RoastedSalsa/Mini-3-DoF-BLDC-Robot-Arm/(list of files, cad)

Other CAD files:
Mark1/analysis/simulink/basic_ik/Base.step
Mark1/analysis/simulink/gravity/Part 2.step
Mark1/analysis/simulink/gravity2/Part 2.step
Mark1/ros2/src/full_assembly/meshes/GT2_20T.stl
Mark1/analysis/simulink/basic_ik/Part 12.step
Mark1/analysis/simulink/gravity/Base1.step
Mark1/analysis/simulink/gravity2/Part 21.step
Mark1/ros2/src/full_assembly/meshes/Link1_Attachment.stl
Mark1/analysis/simulink/basic_ik/Part 14.step
Mark1/analysis/simulink/gravity/Part 21.step
Mark1/analysis/simulink/gravity2/Part 14.step
Mark1/ros2/src/full_assembly/meshes/GM3506_Stator.stl
Mark1/analysis/simulink/basic_ik/Part 21.step
Mark1/analysis/simulink/gravity/Part 12.step
Mark1/analysis/simulink/gravity2/Part 13.step
Mark1/ros2/src/full_assembly/meshes/Link3.stl
Mark1/analysis/simulink/basic_ik/Part 2.step
Mark1/analysis/simulink/gravity/Part 11.step
Mark1/analysis/simulink/gravity2/Part 12.step
Mark1/ros2/src/full_assembly/meshes/Bearring.stl
Mark1/analysis/simulink/basic_ik/Part 13.step
Mark1/analysis/simulink/gravity/Part 1.step
Mark1/analysis/simulink/gravity2/Base.step
Mark1/ros2/src/full_assembly/meshes/GM3506_Rotor.stl
Mark1/analysis/simulink/basic_ik/Part 11.step
Mark1/analysis/simulink/gravity/Part 13.step
Mark1/analysis/simulink/gravity2/Part 11.step
Mark1/ros2/src/full_assembly/meshes/Link2.stl
Mark1/analysis/simulink/basic_ik/Part 1.step
Mark1/analysis/simulink/gravity/Part 14.step
Mark1/analysis/simulink/gravity2/Part 1.step
Mark1/ros2/src/full_assembly/meshes/Base.stl
Mark1/ros2/src/full_assembly/meshes/GBM2804_Rotor.stl
Mark1/ros2/src/full_assembly/meshes/Link1_Body.stl
Mark1/ros2/src/full_assembly/meshes/GBM2804_Stator.stl
