RoastedSalsa/Mini-3-DoF-BLDC-Robot-Arm/Mark1/ros2/src/full_assembly/urdf/full_assembly.urdf

<!--URDF generated by ONSHAPE BY PTC INC, 1.218-->
<robot name="full_assembly">
    <link name="base">
        <inertial>
            <mass value="0.176007" />
            <origin xyz="6.77725e-18 0.000809394 0.0197186" rpy="0 -0 0" />
            <inertia ixx="0.000202067" ixy="0" ixz="0" iyy="0.000207068" iyz="-6.31167e-07" izz="0.000384759" />
        </inertial>
        <visual>
            <origin xyz="1.03684e-19 -2.1684e-18 0.02" rpy="0 -0 0" />
            <geometry>
                <mesh filename="package://full_assembly/meshes/Base.stl" scale="1 1 1" />
            </geometry>
            <material name="0.615686_0.811765_0.929412_0.000000_0.000000">
                <color rgba="0.615686 0.811765 0.929412 1" />
            </material>
        </visual>
    </link>
    <link name="bearring">
        <inertial>
            <mass value="3.43062e-06" />
            <origin xyz="-4.27555e-18 -5.77779e-34 0.0035" rpy="0 -0 0" />
            <inertia ixx="3.19333e-10" ixy="0" ixz="0" iyy="3.19333e-10" iyz="0" izz="6.1065e-10" />
        </inertial>
        <visual>
            <origin xyz="-5.18498e-18 -1.21523e-18 0.0025" rpy="0 -0 0" />
            <geometry>
                <mesh filename="package://full_assembly/meshes/Bearring.stl" scale="1 1 1" />
            </geometry>
            <material name="0.917647_0.917647_0.917647_0.000000_0.000000">
                <color rgba="0.917647 0.917647 0.917647 1" />
            </material>
        </visual>
    </link>
    <link name="earth_mate">
        <inertial>
            <mass value="1e-09" />
            <origin xyz="0 0 0" rpy="0 -0 0" />
            <inertia ixx="4e-14" ixy="0" ixz="0" iyy="4e-14" iyz="0" izz="4e-14" />
        </inertial>
    </link>
    <link name="ee_mate">
        <inertial>
            <mass value="1e-09" />
            <origin xyz="0 0 0" rpy="0 -0 0" />
            <inertia ixx="4e-14" ixy="0" ixz="0" iyy="4e-14" iyz="0" izz="4e-14" />
        </inertial>
    </link>
    <link name="gbm2804_rotor">
        <inertial>
            <mass value="0.0216029" />
            <origin xyz="-9.60258e-20 1.20158e-20 -0.00546488" rpy="0 -0 0" />
            <inertia ixx="1.89079e-06" ixy="0" ixz="0" iyy="1.89079e-06" iyz="0" izz="3.3475e-06" />
        </inertial>
        <visual>
            <origin xyz="2.3486e-19 -1.10246e-18 -0.011" rpy="0 -0 0" />
            <geometry>
                <mesh filename="package://full_assembly/meshes/GBM2804_Rotor.stl" scale="1 1 1" />
            </geometry>
            <material name="0.615686_0.811765_0.929412_0.000000_0.000000">
                <color rgba="0.615686 0.811765 0.929412 1" />
            </material>
        </visual>
    </link>
    <link name="gbm2804_stator">
        <inertial>
            <mass value="0.00883949" />
            <origin xyz="-2.17814e-18 8.26292e-19 -0.00149587" rpy="0 -0 0" />
            <inertia ixx="6.47839e-07" ixy="0" ixz="0" iyy="6.47839e-07" iyz="0" izz="1.23717e-06" />
        </inertial>
        <visual>
            <origin xyz="-2.16634e-18 -1.98046e-19 -0.015" rpy="0 -0 0" />
            <geometry>
                <mesh filename="package://full_assembly/meshes/GBM2804_Stator.stl" scale="1 1 1" />
            </geometry>
            <material name="0.647059_0.647059_0.647059_0.000000_0.000000">
                <color rgba="0.647059 0.647059 0.647059 1" />
            </material>
        </visual>
    </link>
    <link name="gm3506_rotor">
        <inertial>
            <mass value="0.0383311" />
            <origin xyz="-6.99227e-19 -1.14387e-18 -0.00661149" rpy="0 -0 1.5708" />
            <inertia ixx="4.6146e-06" ixy="0" ixz="0" iyy="4.6146e-06" iyz="0" izz="7.78531e-06" />
        </inertial>
        <visual>
            <origin xyz="5.51091e-19 6.11834e-34 -0.014" rpy="0 -0 1.5708" />
            <geometry>
                <mesh filename="package://full_assembly/meshes/GM3506_Rotor.stl" scale="1 1 1" />
            </geometry>
            <material name="0.615686_0.811765_0.929412_0.000000_0.000000">
                <color rgba="0.615686 0.811765 0.929412 1" />
            </material>
        </visual>
    </link>
    <link name="gm3506_rotor_1">
        <inertial>
            <mass value="0.0383311" />
            <origin xyz="-6.99227e-19 -1.14387e-18 -0.00661149" rpy="0 -0 1.5708" />
            <inertia ixx="4.6146e-06" ixy="0" ixz="0" iyy="4.6146e-06" iyz="0" izz="7.78531e-06" />
        </inertial>
        <visual>
            <origin xyz="5.51091e-19 6.11834e-34 -0.014" rpy="0 -0 1.5708" />
            <geometry>
                <mesh filename="package://full_assembly/meshes/GM3506_Rotor.stl" scale="1 1 1" />
            </geometry>
            <material name="0.615686_0.811765_0.929412_0.000000_0.000000">
                <color rgba="0.615686 0.811765 0.929412 1" />
            </material>
        </visual>
    </link>
    <link name="gm3506_stator">
        <inertial>
            <mass value="0.00806633" />
            <origin xyz="-1.52459e-18 -0.000466632 -0.00190339" rpy="0 -0 0" />
            <inertia ixx="9.36986e-07" ixy="0" ixz="0" iyy="1.00259e-06" iyz="1.27752e-11" izz="1.92012e-06" />
        </inertial>
        <visual>
            <origin xyz="0 -1.22465e-18 -0.0178" rpy="0 -0 0" />
            <geometry>
                <mesh filename="package://full_assembly/meshes/GM3506_Stator.stl" scale="1 1 1" />
            </geometry>
            <material name="0.647059_0.647059_0.647059_0.000000_0.000000">
                <color rgba="0.647059 0.647059 0.647059 1" />
            </material>
        </visual>
    </link>
    <link name="gm3506_stator_1">
        <inertial>
            <mass value="0.00806633" />
            <origin xyz="-1.52459e-18 -0.000466632 -0.00190339" rpy="0 -0 0" />
            <inertia ixx="9.36986e-07" ixy="0" ixz="0" iyy="1.00259e-06" iyz="1.27752e-11" izz="1.92012e-06" />
        </inertial>
        <visual>
            <origin xyz="0 -1.22465e-18 -0.0178" rpy="0 -0 0" />
            <geometry>
                <mesh filename="package://full_assembly/meshes/GM3506_Stator.stl" scale="1 1 1" />
            </geometry>
            <material name="0.647059_0.647059_0.647059_0.000000_0.000000">
                <color rgba="0.647059 0.647059 0.647059 1" />
            </material>
        </visual>
    </link>
    <link name="gt2_20t">
        <inertial>
            <mass value="1.18228e-05" />
            <origin xyz="0.00345942 1.29148e-18 -1.92249e-06" rpy="0 -0 0" />
            <inertia ixx="2.02107e-09" ixy="0" ixz="-4.99121e-13" iyy="1.36706e-09" iyz="0" izz="1.36714e-09" />
        </inertial>
        <visual>
            <origin xyz="0.001 0 -2.60237e-19" rpy="0 -0 0" />
            <geometry>
                <mesh filename="package://full_assembly/meshes/GT2_20T.stl" scale="1 1 1" />
            </geometry>
            <material name="0.972549_0.529412_0.003922_0.000000_0.000000">
                <color rgba="0.972549 0.529412 0.00392157 1" />
            </material>
        </visual>
    </link>
    <link name="link1_attachment">
        <inertial>
            <mass value="0.0283697" />
            <origin xyz="-0.0453376 -0.00351665 0.0246244" rpy="0 -0 0" />
            <inertia ixx="5.01432e-06" ixy="-1.53773e-08" ixz="1.92295e-06" iyy="2.25478e-05" iyz="1.64174e-09" izz="1.77649e-05" />
        </inertial>
        <visual>
            <origin xyz="-0.02 0.0245 0" rpy="0 -0 0" />
            <geometry>
                <mesh filename="package://full_assembly/meshes/Link1_Attachment.stl" scale="1 1 1" />
            </geometry>
            <material name="0.615686_0.811765_0.929412_0.000000_0.000000">
                <color rgba="0.615686 0.811765 0.929412 1" />
            </material>
        </visual>
    </link>
    <link name="link1_body">
        <inertial>
            <mass value="0.0510964" />
            <origin xyz="-0.00434002 -0.0111291 0.0209622" rpy="0 -0 0" />
            <inertia ixx="1.80075e-05" ixy="-1.87854e-06" ixz="1.36583e-06" iyy="1.95321e-05" iyz="1.40635e-06" izz="1.31797e-05" />
        </inertial>
        <visual>
            <origin xyz="0 2.60237e-19 0" rpy="0 -0 0" />
            <geometry>
                <mesh filename="package://full_assembly/meshes/Link1_Body.stl" scale="1 1 1" />
            </geometry>
            <material name="0.615686_0.811765_0.929412_0.000000_0.000000">
                <color rgba="0.615686 0.811765 0.929412 1" />
            </material>
        </visual>
    </link>
    <link name="link2">
        <inertial>
            <mass value="0.0906071" />
            <origin xyz="-2.11926e-16 -0.0930749 -0.00660831" rpy="0 -0 0" />
            <inertia ixx="0.000377155" ixy="0" ixz="0" iyy="1.34721e-05" iyz="-3.30071e-06" izz="0.000388504" />
        </inertial>
        <visual>
            <origin xyz="0 8.57253e-19 0.0025" rpy="0 -0 0" />
            <geometry>
                <mesh filename="package://full_assembly/meshes/Link2.stl" scale="1 1 1" />
            </geometry>
            <material name="0.792157_0.819608_0.933333_0.000000_0.000000">
                <color rgba="0.792157 0.819608 0.933333 1" />
            </material>
        </visual>
    </link>
    <link name="link3">
        <inertial>
            <mass value="0.0593435" />
            <origin xyz="-7.74892e-07 0.00676054 0.0719665" rpy="0 -0 0" />
            <inertia ixx="0.00019525" ixy="4.15678e-10" ixz="5.57351e-09" iyy="0.00019374" iyz="-2.66666e-05" izz="8.18807e-06" />
        </inertial>
        <visual>
            <origin xyz="-3.25001e-19 0 -4.33681e-19" rpy="0 -0 0" />
            <geometry>
                <mesh filename="package://full_assembly/meshes/Link3.stl" scale="1 1 1" />
            </geometry>
            <material name="0.615686_0.811765_0.929412_0.000000_0.000000">
                <color rgba="0.615686 0.811765 0.929412 1" />
            </material>
        </visual>
    </link>
    <link name="root" />
    <joint name="bearing_revolute" type="continuous">
        <origin xyz="-5.18498e-18 1.38778e-17 4.33681e-19" rpy="1.01109e-14 7.90371e-15 -1.5708" />
        <axis xyz="-0 -0 1" />
        <parent link="bearring" />
        <child link="link2" />
    </joint>
    <joint name="earth_mate" type="fixed">
        <origin xyz="0 0 -7.70372e-34" rpy="-3.30796e-61 1.97215e-31 -1.99229e-31" />
        <axis xyz="0 0 1" />
        <parent link="base" />
        <child link="earth_mate" />
    </joint>
    <joint name="ee_mate" type="fixed">
        <origin xyz="-2.77556e-17 0.0158 0.2" rpy="1.26218e-29 -1.57772e-30 2.46519e-32" />
        <axis xyz="0 0 1" />
        <parent link="link3" />
        <child link="ee_mate" />
    </joint>
    <joint name="fastened_1" type="fixed">
        <origin xyz="-6.15827e-18 -3.36576e-18 6.93889e-18" rpy="6.43662e-15 -6.43662e-15 -1.5708" />
        <axis xyz="-0 -0 -1" />
        <parent link="root" />
        <child link="base" />
    </joint>
    <joint name="fastened_2" type="fixed">
        <origin xyz="1.38778e-17 0 -0.011" rpy="1.5708 -5.54861e-16 -3.14159" />
        <axis xyz="0 1 0" />
        <parent link="gbm2804_rotor" />
        <child link="link3" />
    </joint>
    <joint name="fastened_3" type="fixed">
        <origin xyz="-3.36576e-18 6.07153e-19 0.03" rpy="-3.14159 1.24633e-15 -2.32179e-15" />
        <axis xyz="0 0 1" />
        <parent link="base" />
        <child link="gm3506_stator_1" />
    </joint>
    <joint name="fastened_4" type="fixed">
        <origin xyz="0.02 -0.0245 6.93889e-18" rpy="-1.43038e-16 5.92868e-16 1.69309e-15" />
        <axis xyz="1.73472e-16 1 -0" />
        <parent link="link1_body" />
        <child link="link1_attachment" />
    </joint>
    <joint name="fastened_5" type="fixed">
        <origin xyz="-0.0778938 1.38778e-17 0.0281002" rpy="1.5708 5.43881e-17 -1.09899e-16" />
        <axis xyz="0 0 1" />
        <parent link="link1_attachment" />
        <child link="gm3506_stator" />
    </joint>
    <joint name="fastened_6" type="fixed">
        <origin xyz="-1.38778e-17 -0.2 -0.002" rpy="-3.14159 -8.84709e-17 -2.77556e-16" />
        <axis xyz="0 0 1" />
        <parent link="link2" />
        <child link="gbm2804_stator" />
    </joint>
    <joint name="fastened_7" type="fixed">
        <origin xyz="-9.18861e-18 0.0028 0.0365" rpy="1.5708 1.1437e-14 3.14159" />
        <axis xyz="0 0 -1" />
        <parent link="link1_body" />
        <child link="bearring" />
    </joint>
    <joint name="fastened_8" type="fixed">
        <origin xyz="2.87792e-19 -8.01187e-32 -0.014" rpy="3.14159 -5.13683e-16 1.5708" />
        <axis xyz="0 0 -1" />
        <parent link="gm3506_rotor_1" />
        <child link="link1_body" />
    </joint>
    <joint name="fastened_9" type="fixed">
        <origin xyz="0 0 -0.014" rpy="0 1.5708 1.5708" />
        <axis xyz="-1 -0 -0" />
        <parent link="gm3506_rotor" />
        <child link="gt2_20t" />
    </joint>
    <joint name="gbm2804_revolute" type="continuous">
        <origin xyz="-1.38778e-17 2.77556e-17 -0.004" rpy="1.52766e-14 -1.39216e-15 2.07169e-15" />
        <axis xyz="-0 -0 1" />
        <parent link="gbm2804_stator" />
        <child link="gbm2804_rotor" />
    </joint>
    <joint name="gm3506_revolute" type="continuous">
        <origin xyz="4.92855e-18 5.38849e-17 -0.0038" rpy="7.06242e-16 -2.11404e-16 -1.19984e-13" />
        <axis xyz="0 0 1" />
        <parent link="gm3506_stator_1" />
        <child link="gm3506_rotor_1" />
    </joint>
    <joint name="gm3506_revolute_1" type="continuous">
        <origin xyz="-5.75928e-16 0 -0.0038" rpy="-3.72737e-16 -2.02003e-14 1.65079e-15" />
        <axis xyz="0 0 1" />
        <parent link="gm3506_stator" />
        <child link="gm3506_rotor" />
    </joint>
</robot>
