RoastedSalsa/Mini-3-DoF-BLDC-Robot-Arm/Mark1/firmware/src/diagnostics/position.cpp

#include "PinNames.h"
#include "variant_NUCLEO_G474RE.h"
#include <Arduino.h>
#include <Wire.h>
#include <SimpleFOC.h>
#include "config.h"

// === Motor selection — comment out to disable ===
#define ENABLE_MOTOR1
#define ENABLE_MOTOR2
#define ENABLE_MOTOR3

// === I2C buses ===
TwoWire myWire1(S1_SDA_PIN, S1_SCL_PIN);  // I2C1 HW — sensor 1 (SDA, SCL)
TwoWire myWire2(S2_SDA_PIN, S2_SCL_PIN);  // I2C3 HW — sensor 2 (SDA, SCL)
TwoWire myWire3(S3_SDA_PIN, S3_SCL_PIN);  // I2C4 HW — sensor 3 (SDA, SCL)

// === Sensors ===
MagneticSensorI2C sensor1 = MagneticSensorI2C(AS5600_I2C);
MagneticSensorI2C sensor2 = MagneticSensorI2C(AS5600_I2C);
MagneticSensorI2C sensor3 = MagneticSensorI2C(AS5600_I2C);

// === Motors ===
BLDCMotor motor1 = BLDCMotor(M1_POLE_PAIRS);
BLDCMotor motor2 = BLDCMotor(M2_POLE_PAIRS);
BLDCMotor motor3 = BLDCMotor(M3_POLE_PAIRS);

// === Drivers ===
BLDCDriver3PWM driver1 = BLDCDriver3PWM(M1_PH_A, M1_PH_B,  M1_PH_C, M1_EN);   // TIM1
BLDCDriver3PWM driver2 = BLDCDriver3PWM(M2_PH_A, M2_PH_B,  M2_PH_C, M2_EN);  // TIM2
BLDCDriver3PWM driver3 = BLDCDriver3PWM(M3_PH_A, M3_PH_B,  M3_PH_C, M3_EN);  // PA6=TIM3_CH1, PB5=TIM3_CH2, PB6=TIM4_CH1 (PB0 unusable: only TIM1_CH2N / TIM3_CH3-via-ALT, both fail in SimpleFOC)

// === Targets ===
float target1 = 4.0f, target2 = -1.0f, target3 = 3.5f;

Commander command = Commander(Serial);

// Print the calibration result for one motor after initFOC().
void reportMotor(const char* name, BLDCMotor& m) {
    Serial.print(name);
    Serial.print(" done  zero_electric_angle=");
    Serial.print(m.zero_electric_angle, 4);
    Serial.print("  dir=");
    Serial.println(m.sensor_direction == Direction::CW ? "CW"
                 : m.sensor_direction == Direction::CCW ? "CCW" : "UNKNOWN");
}

#ifdef ENABLE_MOTOR1
void onTarget1(char* cmd) { command.scalar(&target1, cmd); }
#endif
#ifdef ENABLE_MOTOR2
void onTarget2(char* cmd) { command.scalar(&target2, cmd); }
#endif
#ifdef ENABLE_MOTOR3
void onTarget3(char* cmd) { command.scalar(&target3, cmd); }
#endif

void setup() {
    Serial.begin(115200);
    while (!Serial && millis() < 2000);

    //SimpleFOCDebug::enable(&Serial);   // uncomment for full driver/sensor/FOC init diagnostics

#ifdef ENABLE_MOTOR1
    myWire1.begin();
    myWire1.setClock(I2C_CLOCK_HZ);
    sensor1.init(&myWire1);
    delay(50);

    driver1.voltage_power_supply = SUPPLY_VOLTAGE;
    driver1.init();

    motor1.linkSensor(&sensor1);
    motor1.linkDriver(&driver1);
    motor1.voltage_limit            = VOLTAGE_LIMIT;
    motor1.PID_velocity.P           = 0.3f;
    motor1.PID_velocity.I           = 0.1f;
    motor1.PID_velocity.output_ramp = 1000.0f;
    motor1.P_angle.P                = 10.0f;
    motor1.P_angle.I                = 1.0f;
    motor1.P_angle.D                = 0.05f;
    motor1.velocity_limit           = 100.0f;
    motor1.LPF_velocity.Tf          = 0.01f;
    motor1.zero_electric_angle      = 1.2732f;
    motor1.sensor_direction         = Direction::CW;
    motor1.init();
    motor1.initFOC();
    motor1.controller = MotionControlType::angle;
    reportMotor("M1", motor1);
    command.add('1', onTarget1, "target motor1");
#endif

#ifdef ENABLE_MOTOR2
    myWire2.begin();
    myWire2.setClock(I2C_CLOCK_HZ);
    sensor2.init(&myWire2);
    delay(50);

    driver2.voltage_power_supply = SUPPLY_VOLTAGE;
    driver2.init();

    motor2.linkSensor(&sensor2);
    motor2.linkDriver(&driver2);
    motor2.voltage_limit            = VOLTAGE_LIMIT;
    motor2.PID_velocity.P           = 0.3f;
    motor2.PID_velocity.I           = 0.1f;
    motor2.PID_velocity.output_ramp = 1000.0f;
    motor2.P_angle.P                = 10.0f;
    motor2.P_angle.I                = 1.0f;
    motor2.P_angle.D                = 0.05f;
    motor2.velocity_limit           = 100.0f;
    motor2.LPF_velocity.Tf          = 0.01f;
    motor2.zero_electric_angle      = 0.61210f;
    motor2.sensor_direction         = Direction::CW;
    motor2.init();
    motor2.initFOC();
    motor2.controller = MotionControlType::angle;
    reportMotor("M2", motor2);
    command.add('2', onTarget2, "target motor2");
#endif

#ifdef ENABLE_MOTOR3
    myWire3.begin();
    myWire3.setClock(I2C_CLOCK_HZ);   // closed loop needs fast sensor reads for a clean velocity estimate
    sensor3.init(&myWire3);
    sensor3.update();
    delay(50);

    driver3.voltage_power_supply = SUPPLY_VOLTAGE;
    driver3.init();

    motor3.linkSensor(&sensor3);
    motor3.linkDriver(&driver3);
    motor3.voltage_limit            = VOLTAGE_LIMIT;   // bring-up: lower current -> less PWM EMI on I2C4
    motor3.PID_velocity.P           = 0.3f;
    motor3.PID_velocity.I           = 0.1f;
    //motor3.PID_velocity.D           = 0.0000f;
    motor3.PID_velocity.output_ramp = 1000.0f;                                                      
    motor3.P_angle.P                = 30.0f;
    motor3.P_angle.I                = 5.0f;
    motor3.P_angle.D                = 0.01f;
    motor3.velocity_limit           = 100.0f;
    motor3.LPF_velocity.Tf          = 0.01f;
    motor3.zero_electric_angle      = 2.2273f;
    motor3.sensor_direction         = Direction::CW;
    motor3.init();
    motor3.initFOC();
    motor3.controller = MotionControlType::angle;
    reportMotor("M3", motor3);
    command.add('3', onTarget3, "target motor3");
#endif

    Serial.println("Motors ready.");
}

void loop() {
#ifdef ENABLE_MOTOR1
    target1 = constrain(target1, 2.0f, 5.3f); 
    sensor1.update(); motor1.loopFOC(); motor1.move(target1);
#endif

#ifdef ENABLE_MOTOR2
    target2 = constrain(target2, -4.0f, 1.5f);  
    sensor2.update(); motor2.loopFOC(); motor2.move(target2);
#endif

#ifdef ENABLE_MOTOR3
    target3 = constrain(target3, 0.8f, 6.0f);  
    sensor3.update(); motor3.loopFOC(); motor3.move(target3);
#endif

    static unsigned long lastPrint = 0;
    if (millis() - lastPrint > 200) {
        lastPrint = millis();
#ifdef ENABLE_MOTOR1
        Serial.print("m1: "); Serial.print(sensor1.getAngle(), 3);
#endif
#ifdef ENABLE_MOTOR2
        Serial.print("\tm2: "); Serial.print(sensor2.getAngle(), 3);
#endif
#ifdef ENABLE_MOTOR3
        Serial.print("\tm3: "); Serial.print(sensor3.getAngle(), 3);
#endif
        Serial.println();
    }

    command.run();
}
