RoastedSalsa/Mini-3-DoF-BLDC-Robot-Arm/(commit log)

2026-04-20 Adjusted the sensor and motor pin layout. Adjusted the codes to allow for modular testing, Added limits and initial position sensing for J1. Adjusted platformio files and etc.
2026-06-06 Redid motor setup, adjusted pins accordingly
2026-06-06 Added motor startup constants
2026-06-08 Deleting OLD files and their locations
    [Base.step, Base1.step, Part 1.step, Part 11.step, Part 12.step, Part 13.step, Part 14.step, Part 2.step]
2026-06-08 OLD arduino IDE files archived
2026-06-08 CAD and simulation files moved
    [Base.step, Base1.step, Part 1.step, Part 11.step, Part 12.step, Part 13.step, Part 14.step, Part 2.step]
2026-06-09 Updated Zero Electric angle, removed homing, added more PID constants, trajectory and boundaries
2026-06-09 Added PID tuner to PlatformIO setup
2026-06-10 Fixed comments and added LoopFOC to openloop
    [config.h, openloop.cpp]
2026-06-20 ROS2 and PID tunning setup
2026-06-25 Updated Inverse kinematics and added forward kinematics
2026-06-25 Updated forward kinematics
2026-06-28 Added homing to the main file
2026-07-04 Gravity FF skeleton
    [mini_ranka.urdf]
2026-07-19 Dynamics framework
2026-07-21 Speculative buys are separated further, NULL and False get different decisions
    [Base.stl, Bearring.stl, GBM2804_Rotor.stl, GBM2804_Stator.stl, GM3506_Rotor.stl, GM3506_Stator.stl, GT2_20T.stl, Link1_Attachment.stl]
2026-07-28 Mirror/Mock arm
    [mini_ranka.urdf]
